xzhang03/picodaq/PCB/picodaq/PicoDAQ EEPROM.png

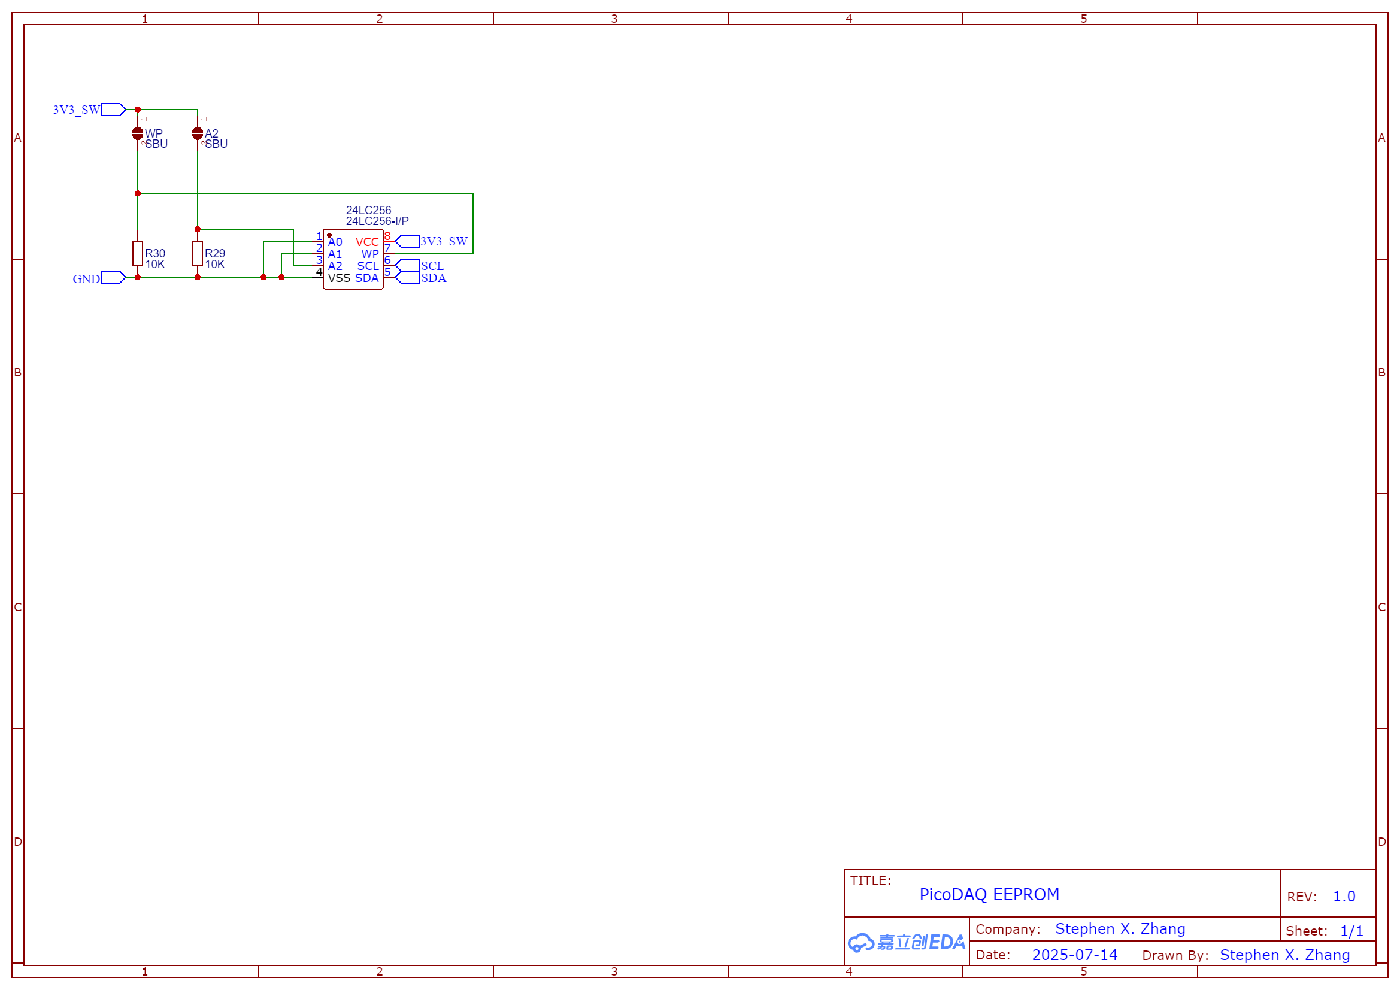
PCB/picodaq/PicoDAQ EEPROM.png
