xzhang03/picodaq/PCB/picodaq_gui/Schematic_Pico_ILI9341_2022-09-15.png

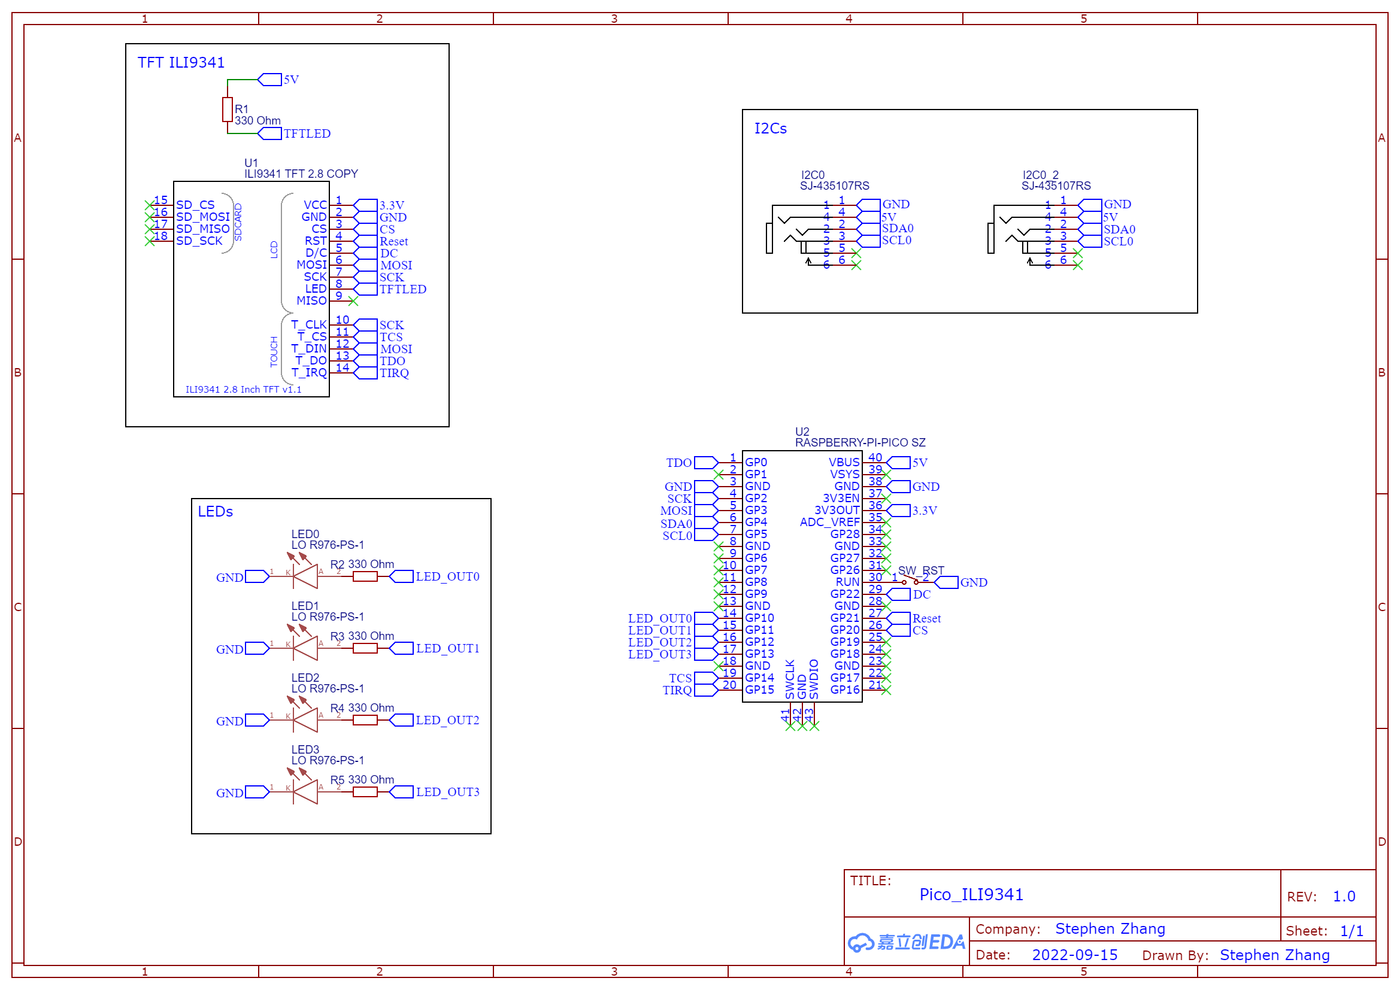
PCB/picodaq_gui/Schematic_Pico_ILI9341_2022-09-15.png
