xzhang03/picodaq/(list of files, drawings)

Other design files:
PCB/picodaq/PCB_PCB_PicoDAQ_2026-06-25.json
PCB/picodaq/SCH_PicoDAQ_2025-07-14.json
PCB/picodaq/SCH_PicoDAQ_2026-06-25.json
PCB/picodaq_gui/PCB_PCB_Pico_ILI9341_2022-09-15.json
PCB/picodaq_gui/SCH_Pico_ILI9341_2022-09-15.json
