xzhang03/picodaq/picodaq_gui/2_sem.ino

// Serial menu
// m table

// ========== operational ==========
// 1: Force replot
// 2: Plot timing
// 3: touch calibration
// 4: regen data (line)
// 5: regen data (square wave)
// 6: data scaling timing
