xzhang03/picodaq/picodaq_gui/User_Setups/Setup105_RP2040_ILI9341_SPI.h

// Stripped down User_Setup.h version for the Pico-Matrix-Touch-Keyboard //<br>
#define ILI9341_DRIVER     // WARNING: Do not connect ILI9488 display SDO to MISO if other devices share the SPI bus (TFT SDO does NOT tristate when CS is high)

#define TFT_MISO  0
#define TFT_MOSI  3
#define TFT_SCLK  2
#define TFT_CS   20  // Chip select control pin
#define TFT_DC   22  // Data Command control pin
#define TFT_RST  21  // Reset pin (could connect to Arduino RESET pin)

#define TOUCH_CS 14     // Chip select pin (T_CS) of touch screen

#define LOAD_GLCD   // Font 1. Original Adafruit 8 pixel font needs ~1820 bytes in FLASH
#define LOAD_FONT2  // Font 2. Small 16 pixel high font, needs ~3534 bytes in FLASH, 96 characters
#define LOAD_FONT4  // Font 4. Medium 26 pixel high font, needs ~5848 bytes in FLASH, 96 characters
#define LOAD_FONT6  // Font 6. Large 48 pixel font, needs ~2666 bytes in FLASH, only characters 1234567890:-.apm
#define LOAD_FONT7  // Font 7. 7 segment 48 pixel font, needs ~2438 bytes in FLASH, only characters 1234567890:-.
#define LOAD_FONT8  // Font 8. Large 75 pixel font needs ~3256 bytes in FLASH, only characters 1234567890:-.
//#define LOAD_FONT8N // Font 8. Alternative to Font 8 above, slightly narrower, so 3 digits fit a 160 pixel TFT
#define LOAD_GFXFF  // FreeFonts. Include access to the 48 Adafruit_GFX free fonts FF1 to FF48 and custom fonts

// Comment out the #define below to stop the SPIFFS filing system and smooth font code being loaded
// this will save ~20kbytes of FLASH
#define SMOOTH_FONT
#define SPI_FREQUENCY  27000000

// Optional reduced SPI frequency for reading TFT
#define SPI_READ_FREQUENCY  20000000

// The XPT2046 requires a lower SPI clock rate of 2.5MHz so we define that here:
#define SPI_TOUCH_FREQUENCY  2500000

// Link
// https://hackaday.io/project/180077-raspberry-pi-pico-matrix-touchscreen-keyboard

// 1. VCC
// 2. GND
// 3. CS = 20
// 4. Reset = 21
// 5. DC = 22
// 6. MOSI = 3
// 7. SCK = 2
// 8. LED = 330R to VCC
// 9. MISO = NC

// Touch-Keyboard
// 10. CLK = 2
// 11. CS = 14
// 12. DIN = 3
// 13. DO = 0
// 14. IRQ = GP15/Optional
