xzhang03/picodaq/(commit log)

2023-03-27 added footprint
2023-04-08 add sample data
2023-04-12 Calibrate channel DC accuracy
2024-05-28 i2c data
2024-05-29 i2c data support
2024-05-29 i2c streaming
2024-05-29 i2c data streaming
2024-10-12 added adc debug mode
2026-06-25 PCB v1.2
    updated to use SMD pico
    [PCB_PCB_PicoDAQ_2025-07-14.json, PCB_PCB_PicoDAQ_2026-06-25.json, SCH_PicoDAQ_2026-06-25.json]
2026-06-25 new footprinte
2026-06-26 updated gerber
